MartinD-CZ/PCB-WordClock/README.md

# Simple PCB tabletop WordClock
*A relatively simple-to-make 100x100 mm WordClock made from 3 PCBs*
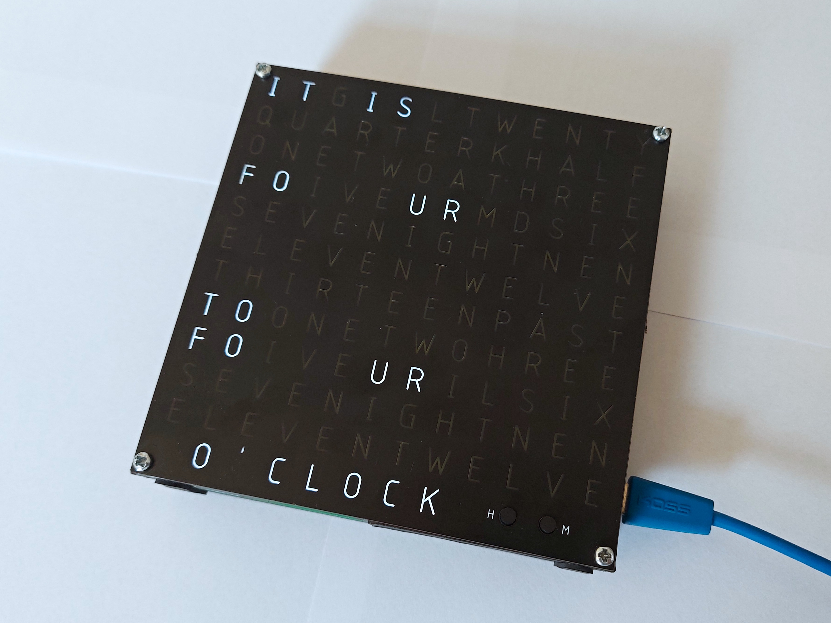
[picture p1: overall_view.jpg]


See [this article](http://embedblog.eu/?p=636) on my blog for more info.
