MartinD-CZ/PCB-WordClock/LED array/led_array_sch.png

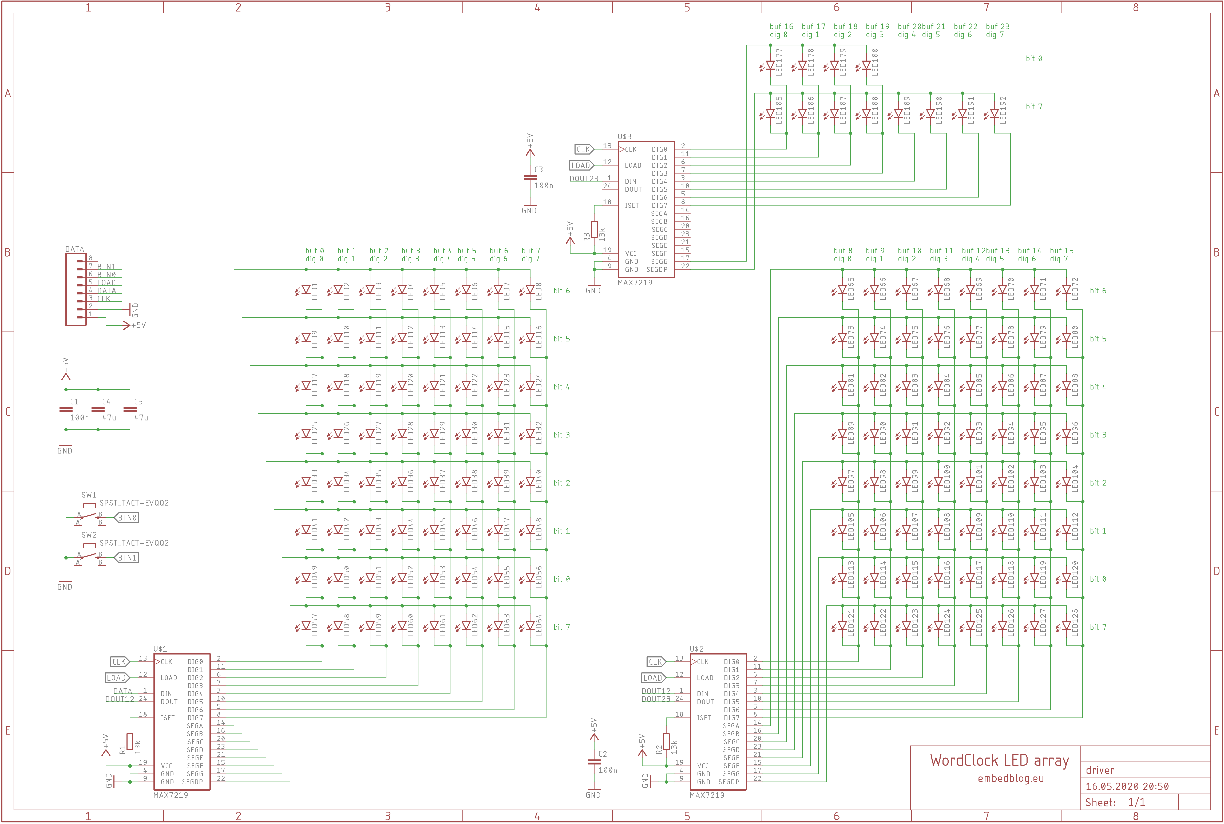
LED array/led_array_sch.png
