MartinD-CZ/PCB-WordClock/3D/word_clock_back.STL

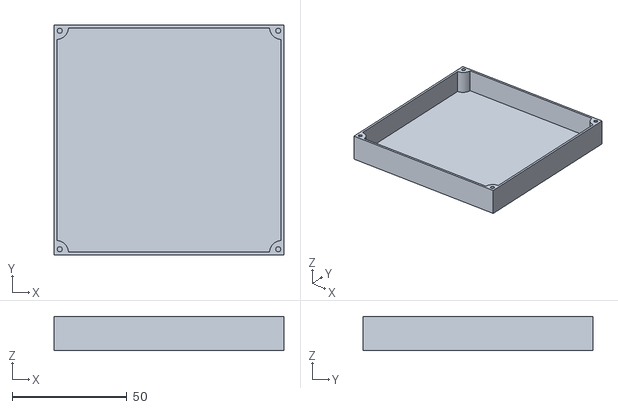
[picture p3: CAD file, 2020-05-16]
3D/word_clock_back.STL
100.0 x 100.0 x 15.0
