MartinD-CZ/PCB-WordClock/3D/word_clock_standoff.STL

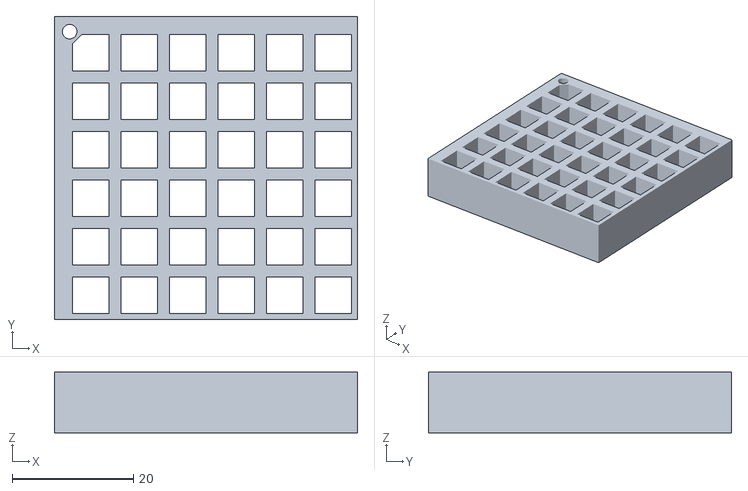
[picture p4: CAD file, 2020-05-16]
3D/word_clock_standoff.STL
50.0 x 50.0 x 10.0
