MartinD-CZ/PCB-WordClock/LED array/driver.brd

## EAGLE design LED array/driver.brd (2020-05-16)

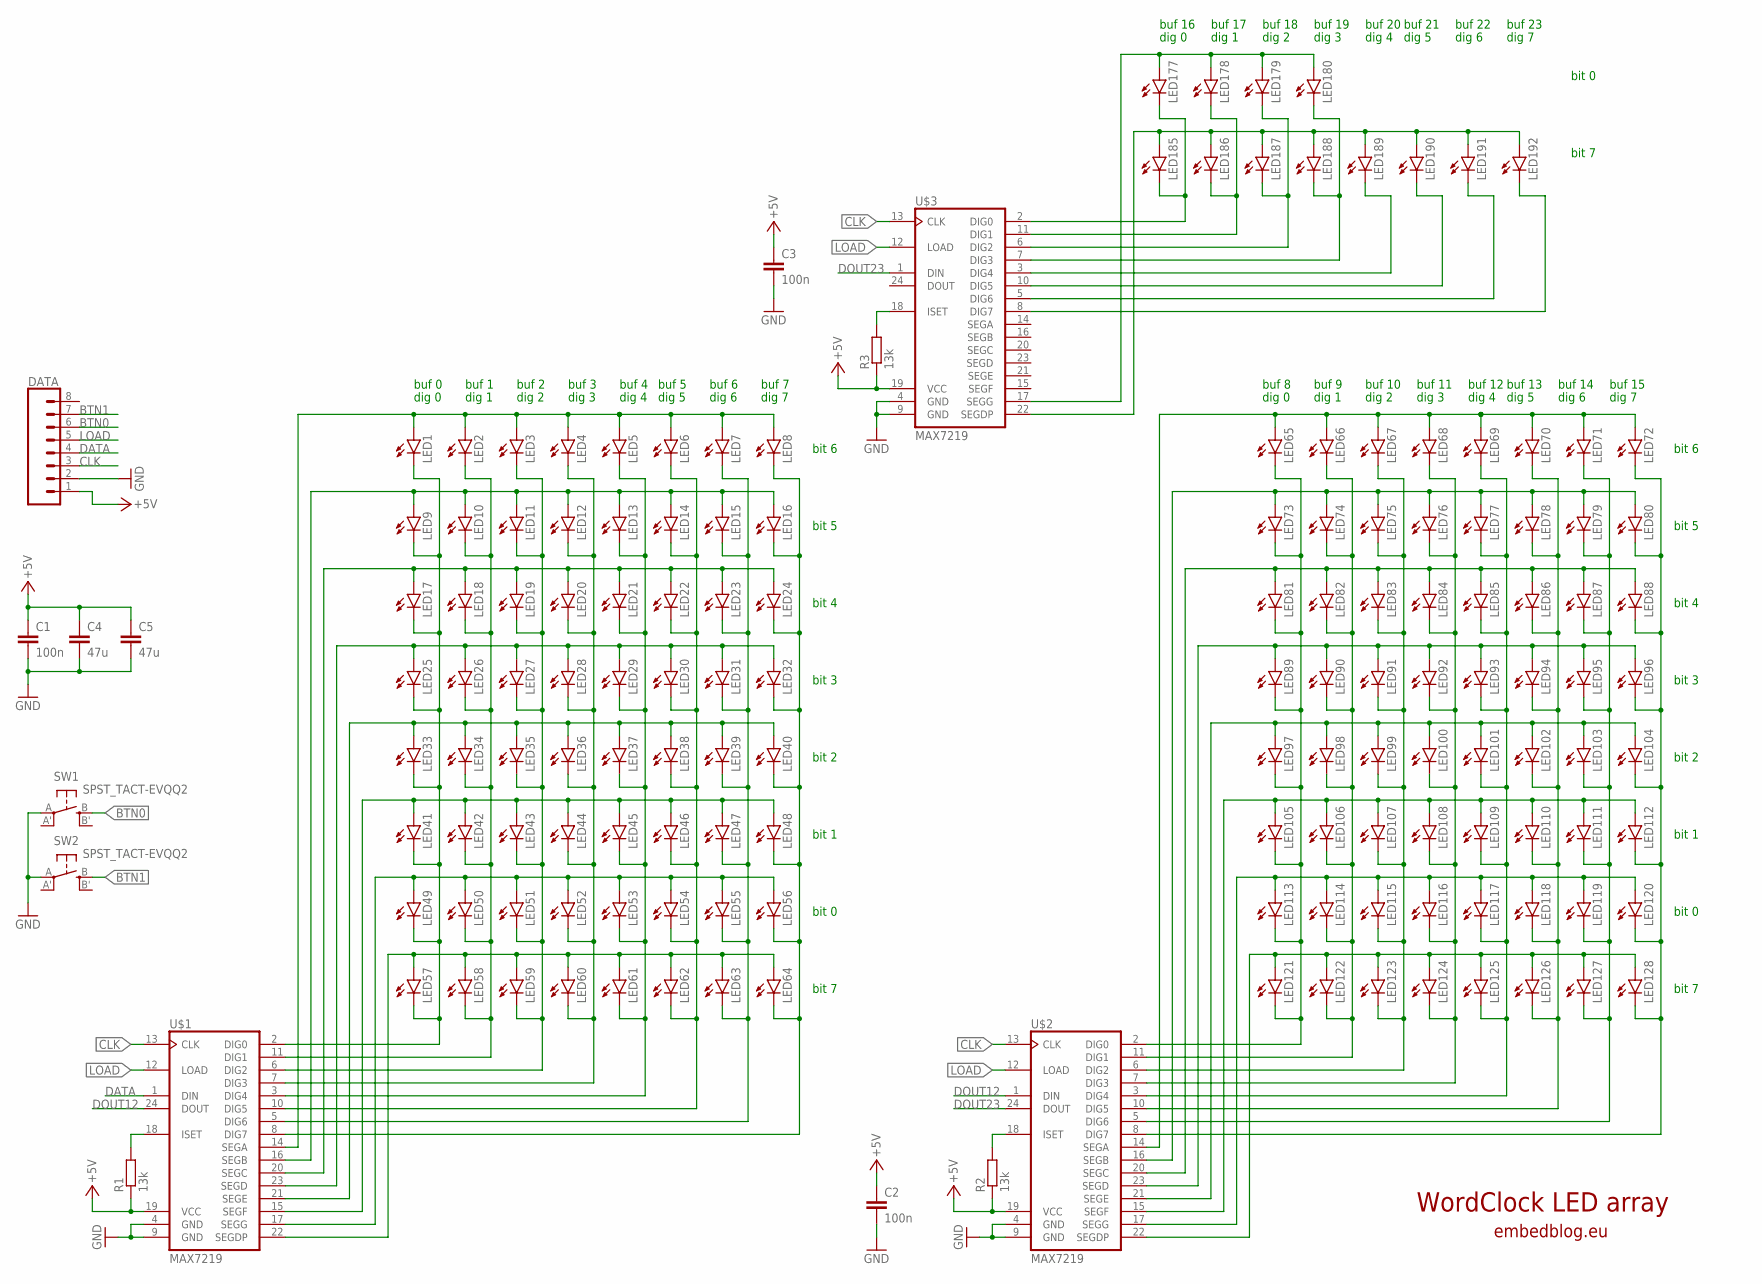
[picture p5: schematic driver.sch]

Parts:
C1, C2, C3: 100n; C1206
C4, C5: 47u; C1206
DATA: CONN_08"; 1X08
LED1, LED2, LED3, LED4, LED5, LED6, LED7, LED8, LED9, LED10, LED11, LED12, LED13, LED14, LED15, LED16, LED17, LED18, LED19, LED20, LED21, LED22, LED23, LED24, LED25, LED26, LED27, LED28, LED29, LED30, LED31, LED32, LED33, LED34, LED35, LED36, LED37, LED38, LED39, LED40, LED41, LED42, LED43, LED44, LED45, LED46, LED47, LED48, LED49, LED50, LED51, LED52, LED53, LED54, LED55, LED56, LED57, LED58, LED59, LED60, LED61, LED62, LED63, LED64, LED65, LED66, LED67, LED68, LED69, LED70, LED71, LED72, LED73, LED74, LED75, LED76, LED77, LED78, LED79, LED80, LED81, LED82, LED83, LED84, LED85, LED86, LED87, LED88, LED89, LED90, LED91, LED92, LED93, LED94, LED95, LED96, LED97, LED98, LED99, LED100, LED101, LED102, LED103, LED104, LED105, LED106, LED107, LED108, LED109, LED110, LED111, LED112, LED113, LED114, LED115, LED116, LED117, LED118, LED119, LED120, LED121, LED122, LED123, LED124, LED125, LED126, LED127, LED128, LED177, LED178, LED179, LED180, LED185, LED186, LED187, LED188, LED189, LED190, LED191, LED192: LEDCHIPLED_1206; CHIPLED_1206
R1, R2, R3: 13k; R1206
SW1, SW2: SPST_TACT-EVQQ2; EVQ-Q2
U$1, U$2, U$3: MAX7219; SO24W

Connections:
+5V: C1.1, C2.1, C3.1, C4.1, C5.1, DATA.1, R1.1, R2.1, R3.1, U$1.19 (VCC), U$2.19 (VCC), U$3.19 (VCC)
BTN0: DATA.6, SW1.B (S)
BTN1: DATA.7, SW2.B (S)
CLK: DATA.3, U$1.13 (CLK), U$2.13 (CLK), U$3.13 (CLK)
DATA: DATA.4, U$1.1 (DIN)
DOUT12: U$1.24 (DOUT), U$2.1 (DIN)
DOUT23: U$2.24 (DOUT), U$3.1 (DIN)
GND: C1.2, C2.2, C3.2, C4.2, C5.2, DATA.2, SW1.A, SW2.A, U$1.4 (GND), U$1.9 (GND), U$2.4 (GND), U$2.9 (GND), U$3.4 (GND), U$3.9 (GND)
LOAD: DATA.5, U$1.12 (LOAD), U$2.12 (LOAD), U$3.12 (LOAD)
unnamed: LED1.A, LED2.A, LED3.A, LED4.A, LED5.A, LED6.A, LED7.A, LED8.A, U$1.14 (SEGA)
unnamed: LED25.A, LED26.A, LED27.A, LED28.A, LED29.A, LED30.A, LED31.A, LED32.A, U$1.23 (SEGD)
unnamed: LED9.A, LED10.A, LED11.A, LED12.A, LED13.A, LED14.A, LED15.A, LED16.A, U$1.16 (SEGB)
unnamed: LED17.A, LED18.A, LED19.A, LED20.A, LED21.A, LED22.A, LED23.A, LED24.A, U$1.20 (SEGC)
unnamed: LED33.A, LED34.A, LED35.A, LED36.A, LED37.A, LED38.A, LED39.A, LED40.A, U$1.21 (SEGE)
unnamed: LED41.A, LED42.A, LED43.A, LED44.A, LED45.A, LED46.A, LED47.A, LED48.A, U$1.15 (SEGF)
unnamed: LED49.A, LED50.A, LED51.A, LED52.A, LED53.A, LED54.A, LED55.A, LED56.A, U$1.17 (SEGG)
unnamed: LED57.A, LED58.A, LED59.A, LED60.A, LED61.A, LED62.A, LED63.A, LED64.A, U$1.22 (SEGDP)
unnamed: LED1.C, LED9.C, LED17.C, LED25.C, LED33.C, LED41.C, LED49.C, LED57.C, U$1.2 (DIG0)
unnamed: R1.2, U$1.18 (ISET)
unnamed: LED65.A, LED66.A, LED67.A, LED68.A, LED69.A, LED70.A, LED71.A, LED72.A, U$2.14 (SEGA)
unnamed: LED73.A, LED74.A, LED75.A, LED76.A, LED77.A, LED78.A, LED79.A, LED80.A, U$2.16 (SEGB)
unnamed: LED81.A, LED82.A, LED83.A, LED84.A, LED85.A, LED86.A, LED87.A, LED88.A, U$2.20 (SEGC)
unnamed: LED89.A, LED90.A, LED91.A, LED92.A, LED93.A, LED94.A, LED95.A, LED96.A, U$2.23 (SEGD)
unnamed: LED97.A, LED98.A, LED99.A, LED100.A, LED101.A, LED102.A, LED103.A, LED104.A, U$2.21 (SEGE)
unnamed: LED105.A, LED106.A, LED107.A, LED108.A, LED109.A, LED110.A, LED111.A, LED112.A, U$2.15 (SEGF)
unnamed: LED2.C, LED10.C, LED18.C, LED26.C, LED34.C, LED42.C, LED50.C, LED58.C, U$1.11 (DIG1)
unnamed: LED113.A, LED114.A, LED115.A, LED116.A, LED117.A, LED118.A, LED119.A, LED120.A, U$2.17 (SEGG)
unnamed: LED121.A, LED122.A, LED123.A, LED124.A, LED125.A, LED126.A, LED127.A, LED128.A, U$2.22 (SEGDP)
unnamed: LED65.C, LED73.C, LED81.C, LED89.C, LED97.C, LED105.C, LED113.C, LED121.C, U$2.2 (DIG0)
unnamed: LED66.C, LED74.C, LED82.C, LED90.C, LED98.C, LED106.C, LED114.C, LED122.C, U$2.11 (DIG1)
unnamed: LED67.C, LED75.C, LED83.C, LED91.C, LED99.C, LED107.C, LED115.C, LED123.C, U$2.6 (DIG2)
unnamed: LED68.C, LED76.C, LED84.C, LED92.C, LED100.C, LED108.C, LED116.C, LED124.C, U$2.7 (DIG3)
unnamed: LED69.C, LED77.C, LED85.C, LED93.C, LED101.C, LED109.C, LED117.C, LED125.C, U$2.3 (DIG4)
unnamed: LED3.C, LED11.C, LED19.C, LED27.C, LED35.C, LED43.C, LED51.C, LED59.C, U$1.6 (DIG2)
unnamed: LED70.C, LED78.C, LED86.C, LED94.C, LED102.C, LED110.C, LED118.C, LED126.C, U$2.10 (DIG5)
unnamed: LED71.C, LED79.C, LED87.C, LED95.C, LED103.C, LED111.C, LED119.C, LED127.C, U$2.5 (DIG6)
unnamed: LED72.C, LED80.C, LED88.C, LED96.C, LED104.C, LED112.C, LED120.C, LED128.C, U$2.8 (DIG7)
unnamed: R2.2, U$2.18 (ISET)
unnamed: LED4.C, LED12.C, LED20.C, LED28.C, LED36.C, LED44.C, LED52.C, LED60.C, U$1.7 (DIG3)
unnamed: LED177.A, LED178.A, LED179.A, LED180.A, U$3.17 (SEGG)
unnamed: LED185.A, LED186.A, LED187.A, LED188.A, LED189.A, LED190.A, LED191.A, LED192.A, U$3.22 (SEGDP)
unnamed: LED177.C, LED185.C, U$3.2 (DIG0)
unnamed: LED178.C, LED186.C, U$3.11 (DIG1)
unnamed: LED5.C, LED13.C, LED21.C, LED29.C, LED37.C, LED45.C, LED53.C, LED61.C, U$1.3 (DIG4)
unnamed: LED179.C, LED187.C, U$3.6 (DIG2)
unnamed: LED180.C, LED188.C, U$3.7 (DIG3)
unnamed: LED189.C, U$3.3 (DIG4)
unnamed: LED190.C, U$3.10 (DIG5)
unnamed: LED191.C, U$3.5 (DIG6)
unnamed: LED192.C, U$3.8 (DIG7)
unnamed: R3.2, U$3.18 (ISET)
unnamed: LED6.C, LED14.C, LED22.C, LED30.C, LED38.C, LED46.C, LED54.C, LED62.C, U$1.10 (DIG5)
unnamed: LED7.C, LED15.C, LED23.C, LED31.C, LED39.C, LED47.C, LED55.C, LED63.C, U$1.5 (DIG6)
unnamed: LED8.C, LED16.C, LED24.C, LED32.C, LED40.C, LED48.C, LED56.C, LED64.C, U$1.8 (DIG7)

Notes on the sheet:
bit 0
bit 1
bit 2
bit 3
bit 4
bit 5
bit 6
bit 7
dig 0
dig 1
dig 2
dig 3
dig 4
dig 5
dig 6
dig 7
buf 0
buf 1
buf 2
buf 4
buf 5
buf 6
buf 7
buf 3
buf 8
buf 9
buf 10
buf 12
buf 13
buf 14
buf 15
buf 11
buf 16
buf 17
buf 18
buf 20
buf 21
buf 22
buf 23
buf 19
WordClock LED array
embedblog.eu

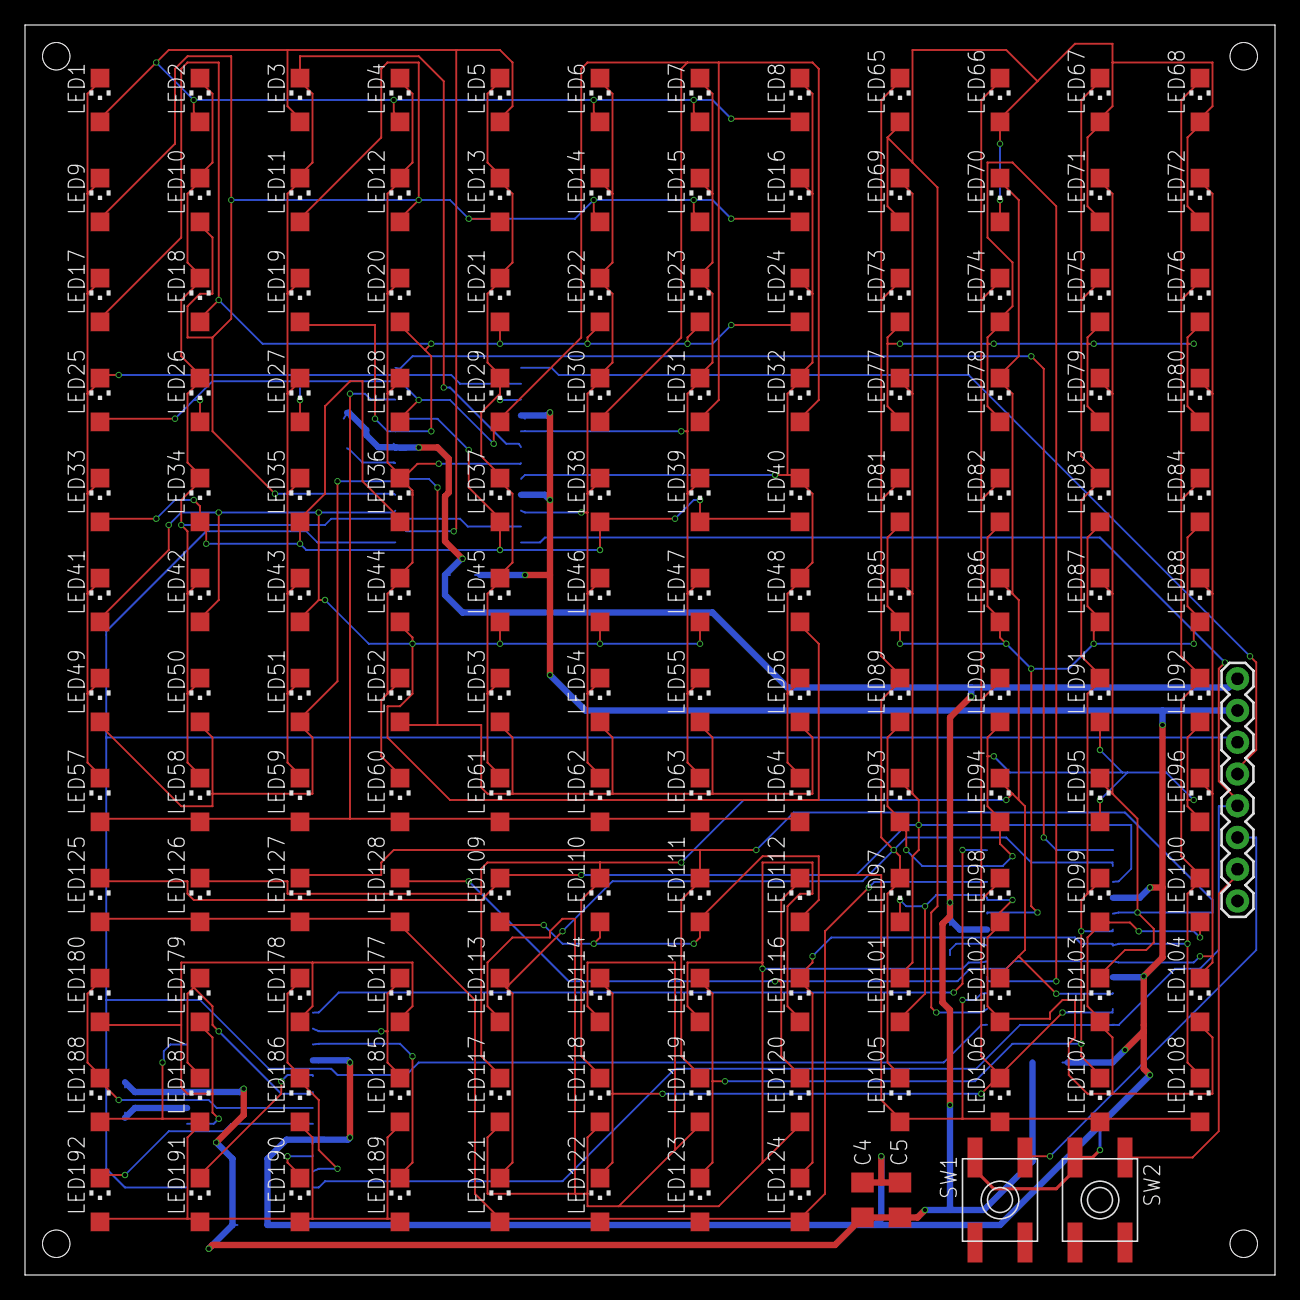
[picture p6: board driver.brd from above]

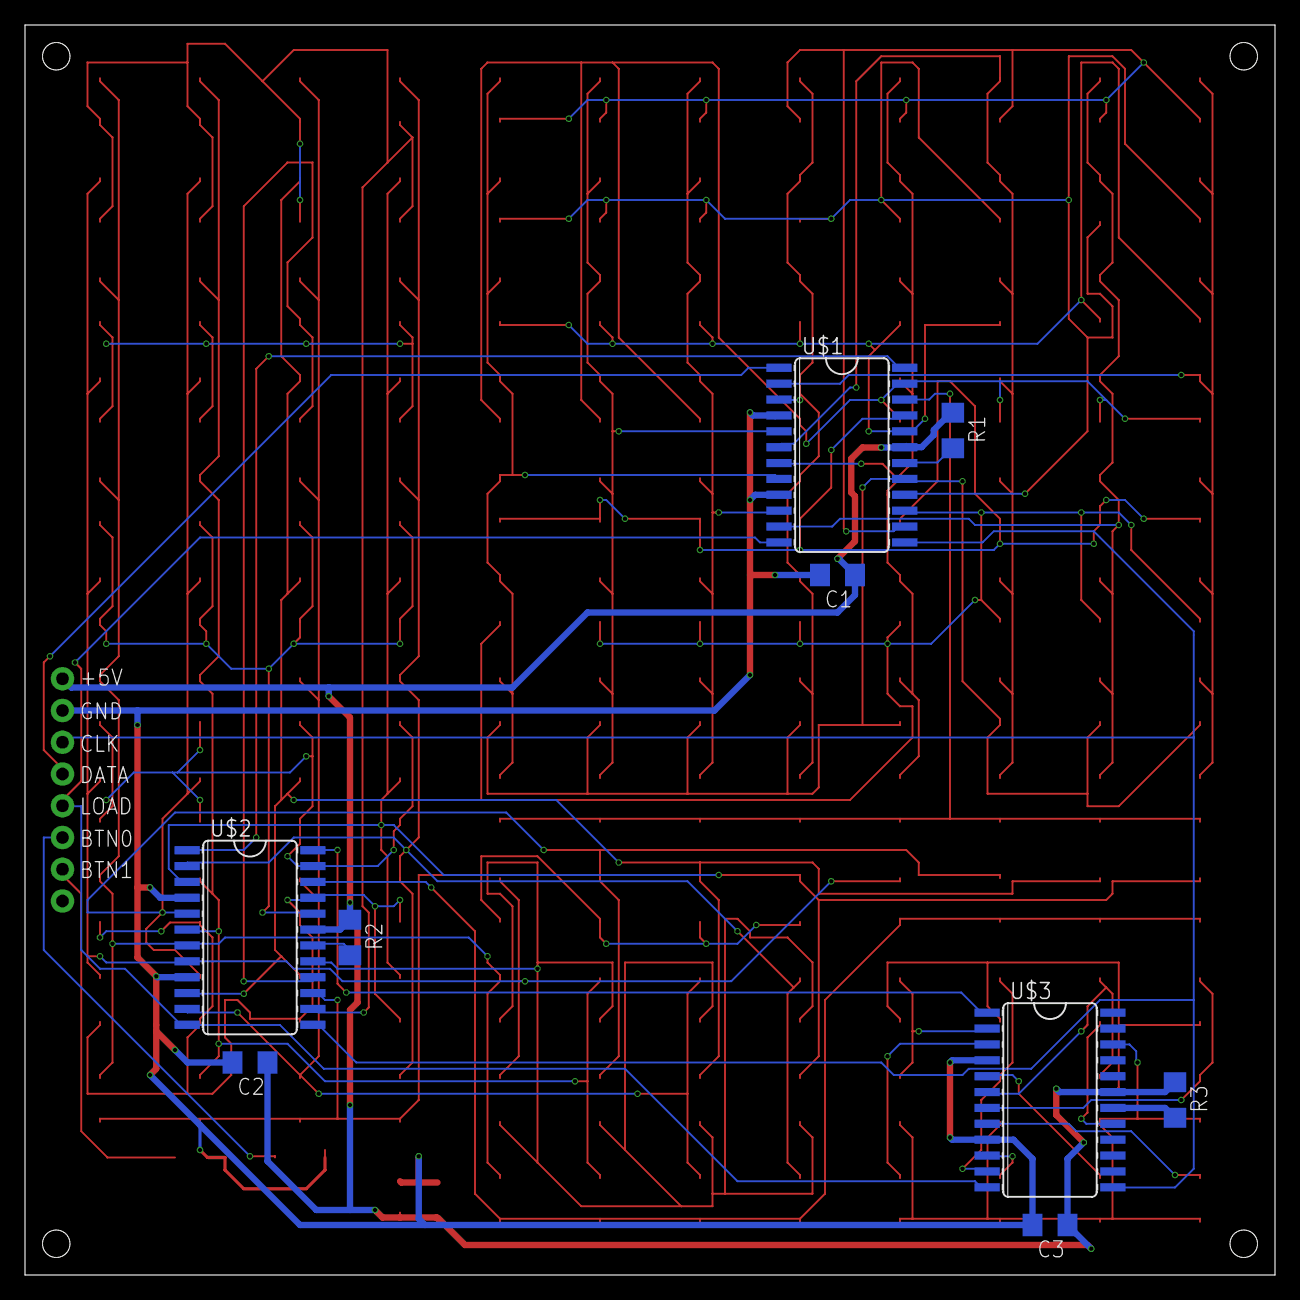
[picture p7: board driver.brd from below]

Board: 2 copper layers, 100.0 x 100.0 mm, 154 parts (9 on the bottom side), 54 nets.
