MartinD-CZ/PCB-WordClock/RTC-DS1307/rtc_module.brd

## EAGLE design RTC-DS1307/rtc_module.brd (2020-05-16)

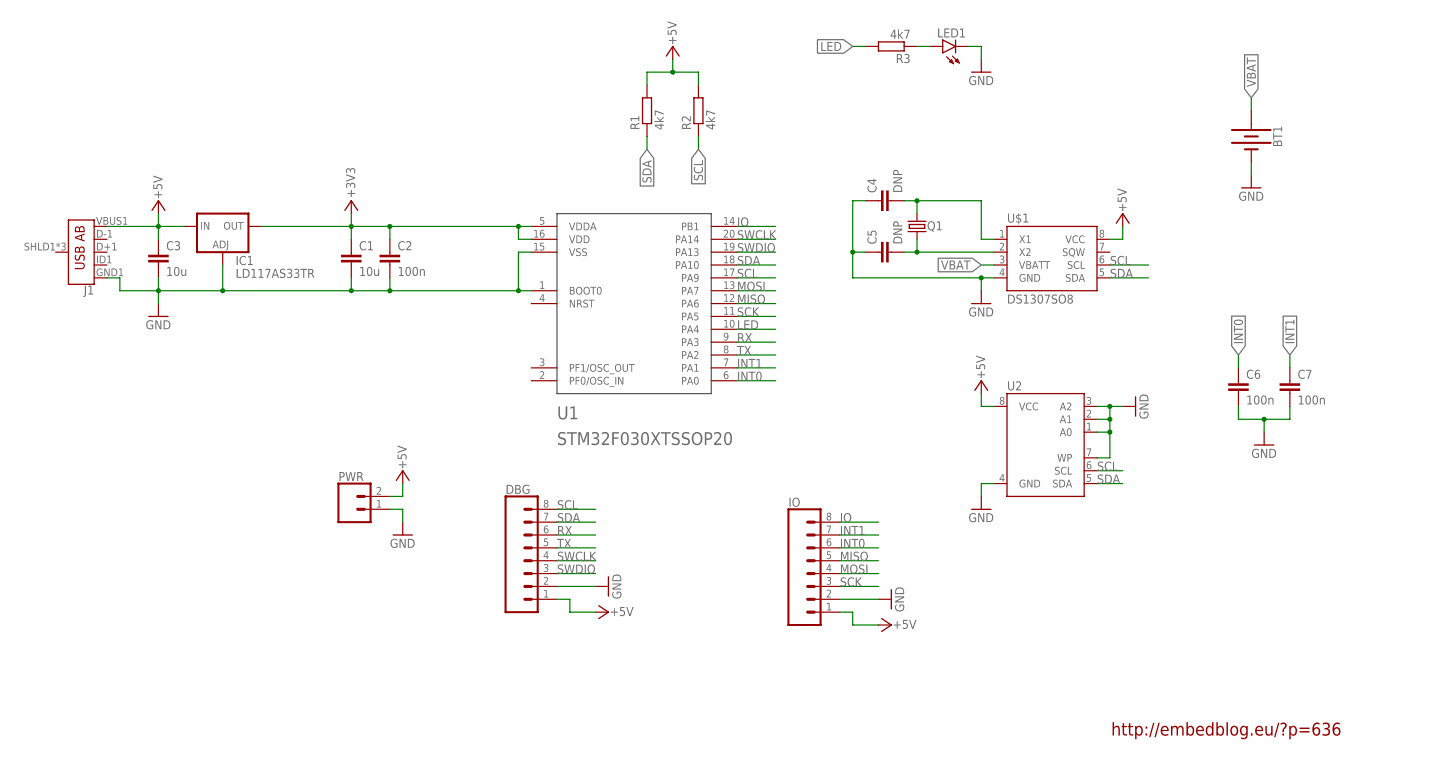
[picture p8: schematic rtc_module.sch]

Parts:
BT1: BATTERY-20MM_PTH; BATTCOM_20MM_PTH
C1, C3: 10u; C1206
C2, C6, C7: 100n; C1206
C4, C5: DNP; C1206
DBG: CONN_08"; 1X08
IC1: LD117AS33TR; SOT223
IO: CONN_08"; 1X08
J1: USB_AB_SMT; USB-AB-MICRO-SMD
LED1: LEDCHIPLED_1206; CHIPLED_1206
PWR: CONN_02PTH3; 1X02_LONGPADS
Q1: CRYSTALTC38H; TC38H
R1, R2, R3: 4k7; R1206
U1: STM32F030XTSSOP20; TSSOP-20
U2: 24LCXX; SOIC8
U$1: DS1307SO8; SO08

Connections:
+3V3: C1.1, C2.1, IC1.4 (OUT), U1.5 (VDDA), U1.16 (VDD)
+5V: C3.1, DBG.1, IC1.3 (IN), IO.1, J1.VBUS1 (VBUS), PWR.2, R1.2, R2.2, U2.8 (VCC), U$1.8 (VCC)
GND: BT1.2 (-), C1.2, C2.2, C3.2, C4.1, C5.1, C6.2, C7.2, DBG.2, IC1.1 (ADJ), IO.2, J1.GND1 (GND), LED1.C, PWR.1, U1.1 (BOOT0), U1.15 (VSS), U2.1 (A0), U2.2 (A1), U2.3 (A2), U2.4 (GND), U2.7 (WP), U$1.4 (GND)
INT0: C6.1, IO.6, U1.6 (PA0)
INT1: C7.1, IO.7, U1.7 (PA1)
IO: IO.8, U1.14 (PB1)
LED: R3.2, U1.10 (PA4)
MISO: IO.5, U1.12 (PA6)
MOSI: IO.4, U1.13 (PA7)
unnamed: C5.2, Q1.1, U$1.2 (X2)
unnamed: C4.2, Q1.2, U$1.1 (X1)
unnamed: LED1.A, R3.1
RX: DBG.6, U1.9 (PA3)
SCK: IO.3, U1.11 (PA5)
SCL: DBG.8, R2.1, U1.17 (PA9), U2.6 (SCL), U$1.6 (SCL)
SDA: DBG.7, R1.1, U1.18 (PA10), U2.5 (SDA), U$1.5 (SDA)
SWCLK: DBG.4, U1.20 (PA14)
SWDIO: DBG.3, U1.19 (PA13)
TX: DBG.5, U1.8 (PA2)
VBAT: BT1.1 (+), U$1.3 (VBATT)

Notes on the sheet:
http://embedblog.eu/?p=636

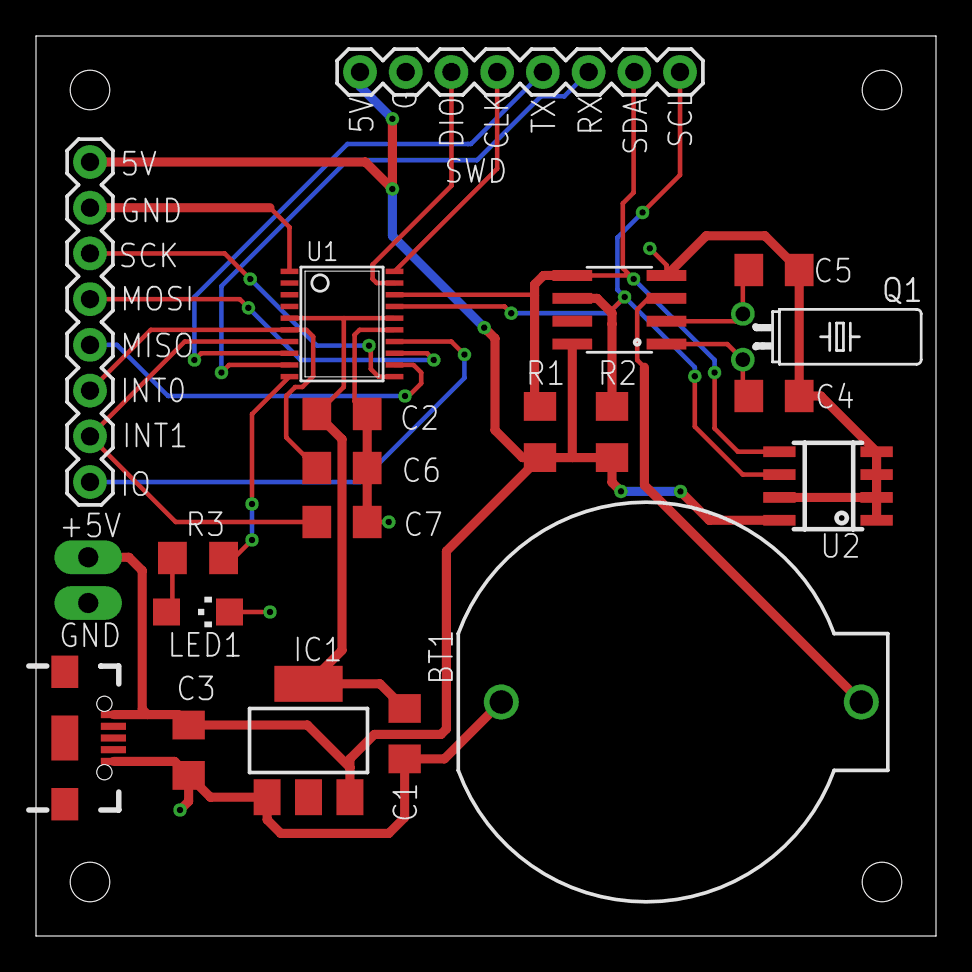
[picture p9: board rtc_module.brd from above]

Board: 2 copper layers, 50.0 x 50.0 mm, 21 parts (0 on the bottom side), 20 nets.
