MartinD-CZ/PCB-WordClock/RTC-ESP8266/rtc_esp8266.brd

## EAGLE design RTC-ESP8266/rtc_esp8266.brd (2020-05-16)

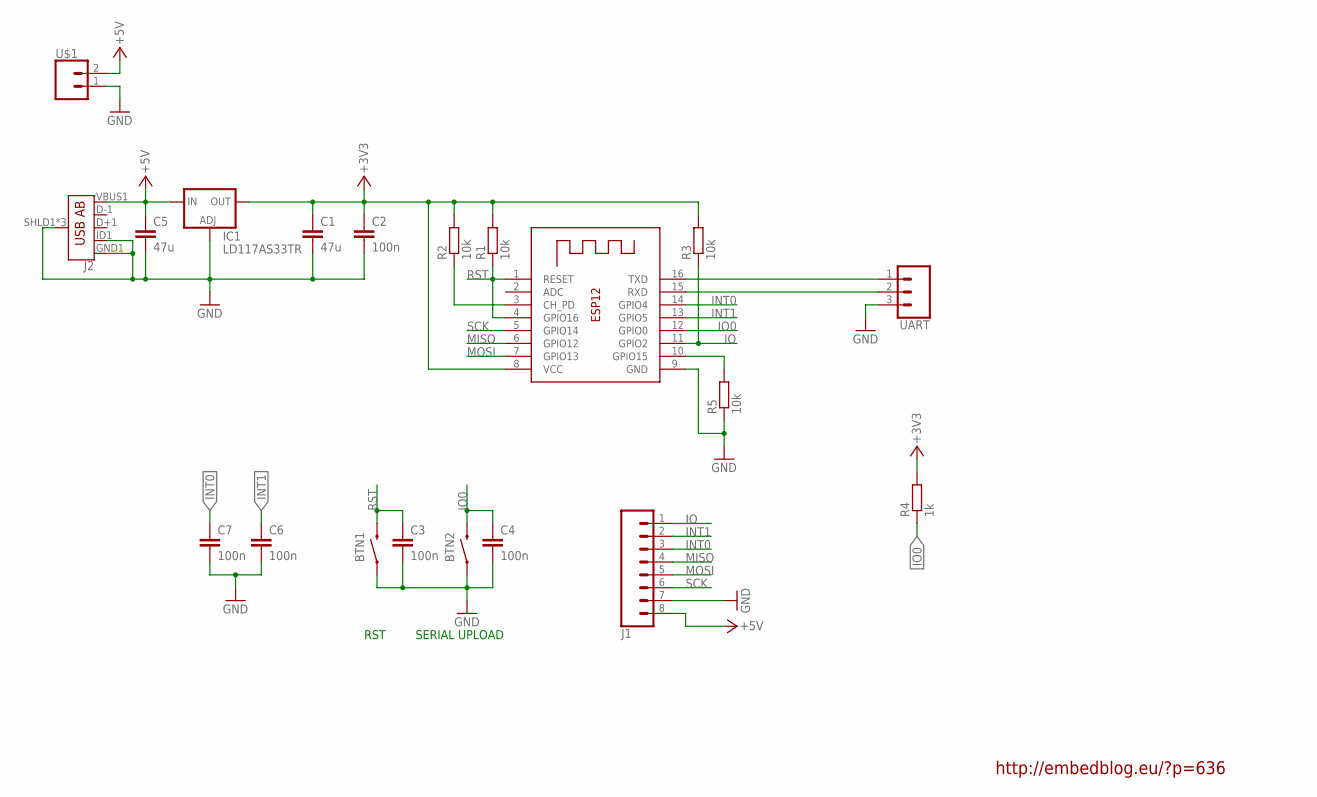
[picture p10: schematic rtc_esp8266.sch]

Parts:
BTN1, BTN2: MOMENTARY-SWITCH-SPST-SMD-5.2MM; TACTILE_SWITCH_SMD_5.2MM
C1, C5: 47u; C1206
C2, C3, C4, C6, C7: 100n; C1206
IC1: LD117AS33TR; SOT223
J1: CONN_08"; 1X08
J2: USB_AB_SMT; USB-AB-MICRO-SMD
R1, R2, R3, R5: 10k; R1206
R4: 1k; R1206
U$1: CONN_02PTH3; 1X02_LONGPADS
UART: 455-1750-1-ND; 1X03
X1: ESP-12

Connections:
+3V3: C1.1, C2.1, IC1.4 (OUT), R1.2, R2.2, R3.2, R4.2, X1.8 (VCC)
+5V: C5.1, IC1.3 (IN), J1.8, J2.VBUS1 (VBUS), U$1.2
GND: BTN1.1, BTN2.1, C1.2, C2.2, C3.2, C4.2, C5.2, C6.2, C7.2, IC1.1 (ADJ), J1.7, J2.GND1 (GND), J2.ID1 (USBID), J2.SHLD1 (SHIELD), J2.SHLD2 (SHIELD), J2.SHLD3 (SHIELD), R5.1, U$1.1, UART.3, X1.9 (GND)
INT0: C7.1, J1.3, X1.14 (GPIO4)
INT1: C6.1, J1.2, X1.13 (GPIO5)
IO: J1.1, R3.1, X1.11 (GPIO2)
IO0: BTN2.3 (2), C4.1, R4.1, X1.12 (GPIO0)
MISO: J1.4, X1.6 (GPIO12)
MOSI: J1.5, X1.7 (GPIO13)
unnamed: R2.1, X1.3 (CH_PD)
unnamed: R5.2, X1.10 (GPIO15)
RST: BTN1.3 (2), C3.1, R1.1, X1.1 (RESET), X1.4 (GPIO16)
RX: UART.2, X1.15 (RXD)
SCK: J1.6, X1.5 (GPIO14)
TX: UART.1, X1.16 (TXD)

Notes on the sheet:
RST
SERIAL UPLOAD
http://embedblog.eu/?p=636

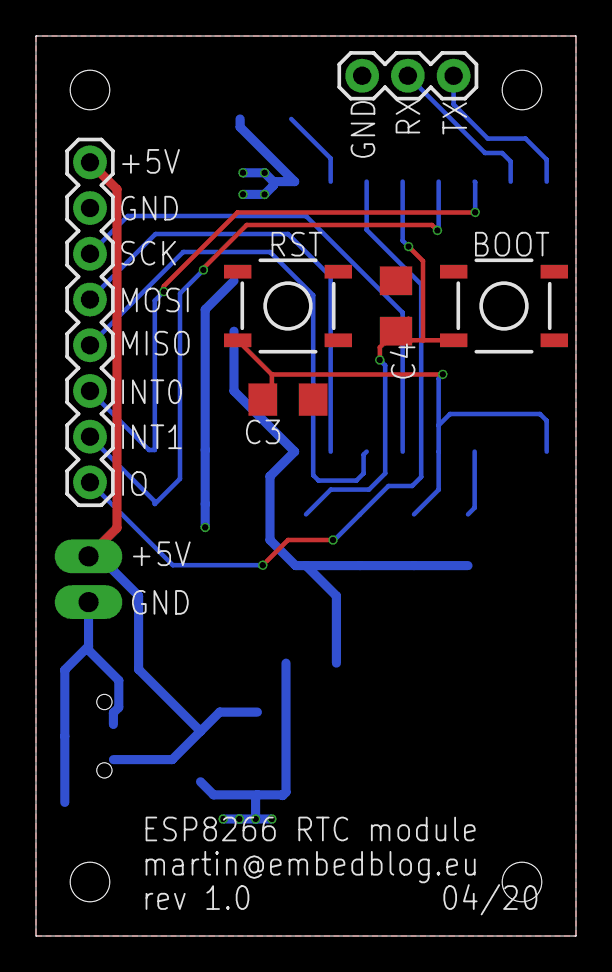
[picture p11: board rtc_esp8266.brd from above]

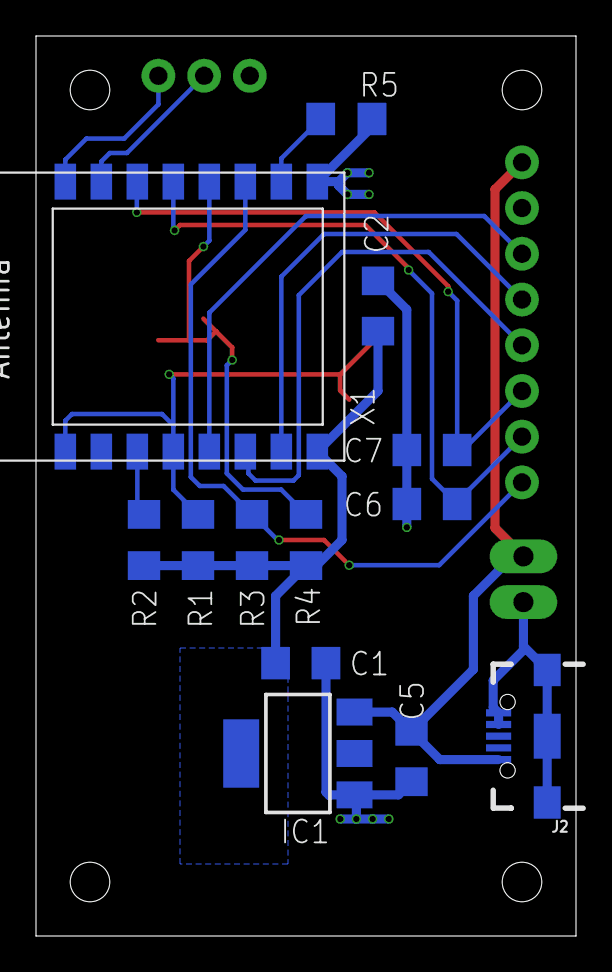
[picture p12: board rtc_esp8266.brd from below]

Board: 2 copper layers, 30.0 x 50.0 mm, 20 parts (13 on the bottom side), 15 nets.
